jp112sdl/HB-OU-AF-SEN-TEMP/README.md

# HB-OU-AF-SEN-TEMP

Homematic AirFlap Control with Temperature Sensor - Kamin-Luftklappensteuerung mit Temperatursensor (MAX6675) im Rauchrohr<br/>
_benötigt [JP-HB-Devices Addon Version 4.2 oder höher](https://github.com/jp112sdl/JP-HB-Devices-addon/releases)_
<br/>
😤 Ich war es leid, zum Regulieren der Luftzufuhr des Kamins jedes Mal aufstehen zu müssen.<br/>
💡 Eine Automatisierung musste her!<br/><br/>
Wie gut, dass ich erst kürzlich einen defekten 3D Drucker zerlegt hatte, der als idealer Teilespender diente.<br/>
So hatte ich einen NEMA17 Stepper Motor, Linearführung, Umlenkrolle etc. sofort zur Verfügung.<br/>
Der zerlegte Extruder passte auch mit leichten Anpassungen wunderbar unter den "Luftklappen-Nupsi" 😂 der Kamintür.<br/>
<br/>
Die nun noch benötigten Teile habe ich komplett auf Tinkercad konstruiert <br/>
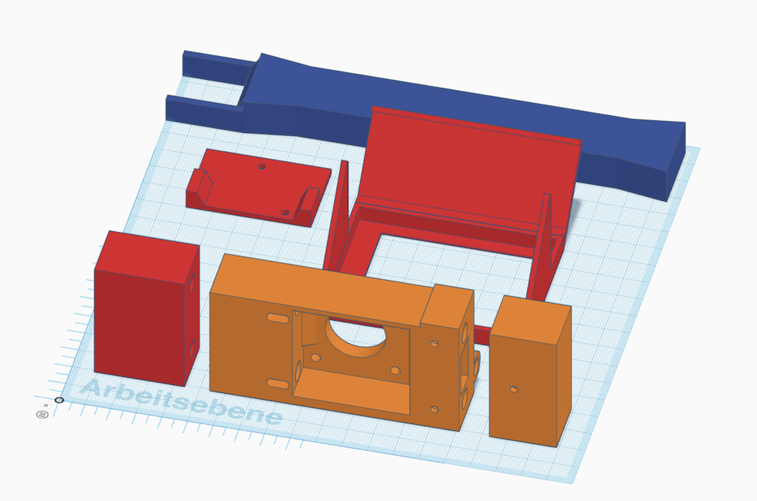
[picture p1: Images/tinkercad.png]
<br/>
und anschließend - wegen der besseren Temperaturbeständigkeit - mit **PETG** gedruckt.

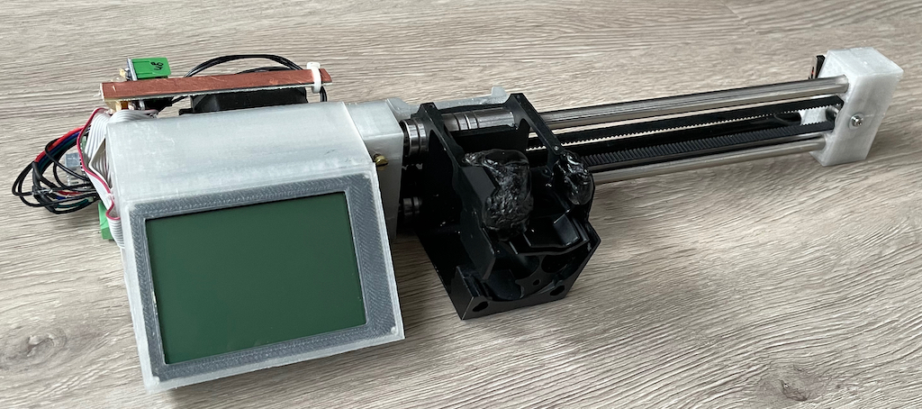
[picture p2: Images/IMG_2078.jpeg]
B1

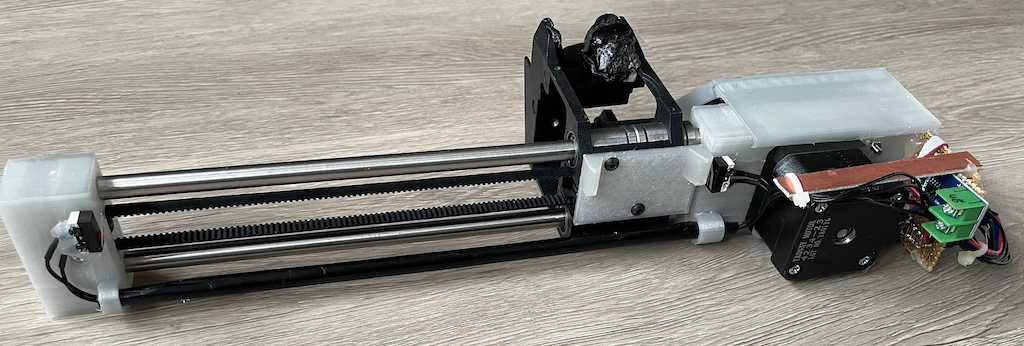
[picture p3: Images/IMG_2079.jpeg]
B2


Die Elektronik:<br/>
Aus meinem [Funkgeräte-Bedienteil-Recycling](https://homematic-forum.de/forum/viewtopic.php?f=76&t=61693&p=610949#p610949) war noch jede Menge übrig, so dass ich mich in erster Linie daran bediente.<br/>
Im Detail habe ich verwendet:<br/>
- ATmega128 AVR mit 14MHz ext. Quarz
- TM12864 LCD Display
- A4988 Stepper Motor Driver
- MAX6675 K-Typ Temperatursensor
- 2 Microschalter als End-Stopps
- CC1101 Funkmodul 868MHz

Verbaut am Kamin:
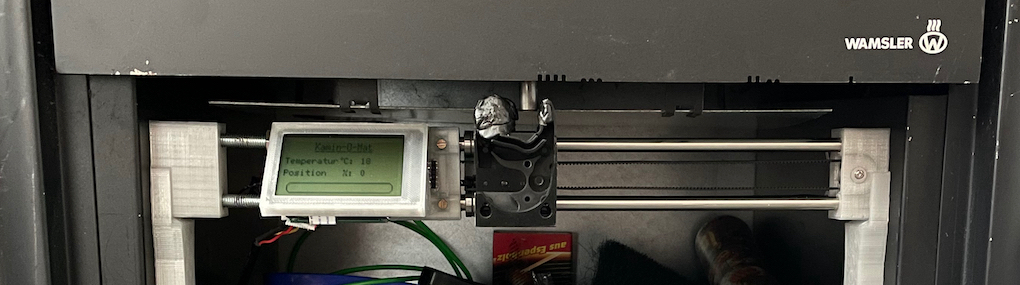
[picture p4: Images/IMG_2085.jpeg]
B3


<br/><br/>
Bei der ersten Inbetriebnahme erfolgt eine automatische Kalibierung.<br/>
Es wird die Anzahl der Schritte zwischen beiden End-Stopps ermittelt und abgespeichert.<br/>
Somit kann dann präzise eine Position (in % der Strecke) angefahren werden.<br/>
<br/><br/>
Steuerung über Homematic:
vid
Higher Quality Video: [click here](https://github.com/jp112sdl/HB-OU-AF-SEN-TEMP/raw/master/Images/IMG_2086.mov)
<br/>
<br/>
Nach dem Anfahren der Position wird der Stepper Motor freigegeben, so dass jederzeit ein manuelles Verschieben möglich ist.<br/>
Leider habe ich keine Möglichkeit gefunden, zuverlässig die absolute Position des Schlittens zu bestimmen.<br/>
Es ist daher notwendig, bei jeder Remote-Ansteuerung zunächst den linken End-Stopp (Nullpunkt) und dann erst die Zielposition anzufahren.
<br/>
<br/>
Zusätzlich ist noch ein MAX6675 Temperatursensor verbaut, der die Temperatur im Abgasrohr misst.
Mithilfe eines kleines Skriptes lasse ich mich über Pushover benachrichtigen, wenn es Zeit wird, Holz nachzulegen.
