jp112sdl/HB-OU-AF-SEN-TEMP/Images/IMG_2080.jpeg

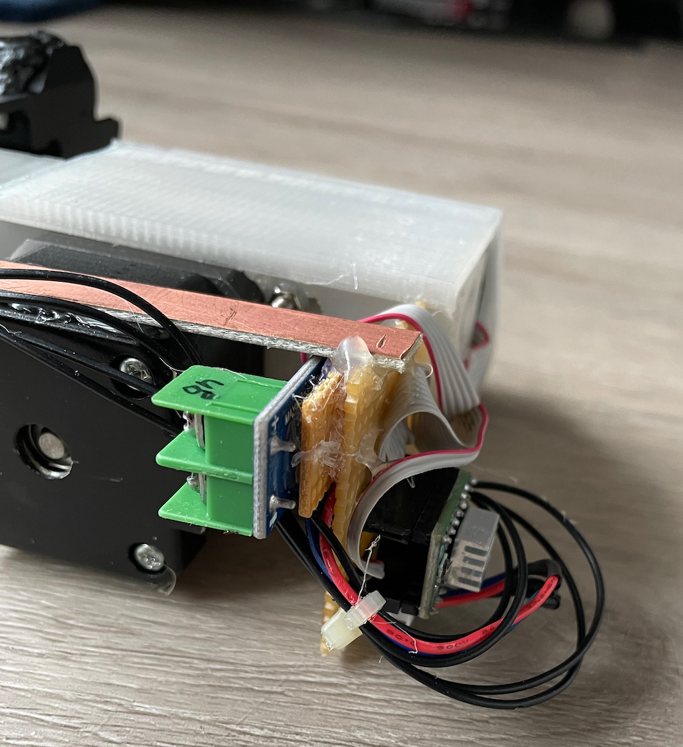
Images/IMG_2080.jpeg
