jp112sdl/HB-OU-AF-SEN-TEMP/Images/IMG_2081.jpeg

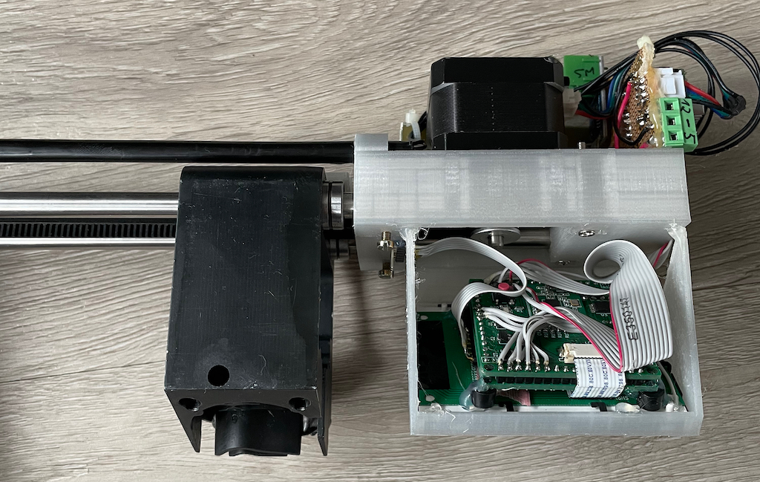
Images/IMG_2081.jpeg
