jp112sdl/HB-OU-AF-SEN-TEMP/Images/IMG_2082.jpeg

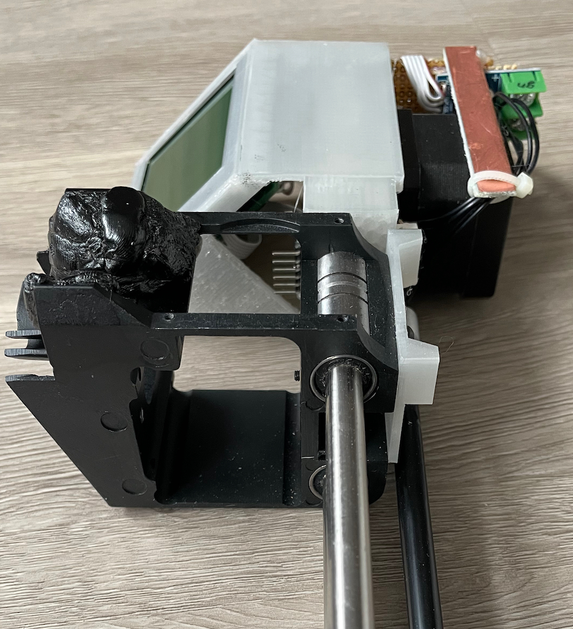
Images/IMG_2082.jpeg
