jp112sdl/HB-OU-AF-SEN-TEMP/Images/IMG_2083.jpeg

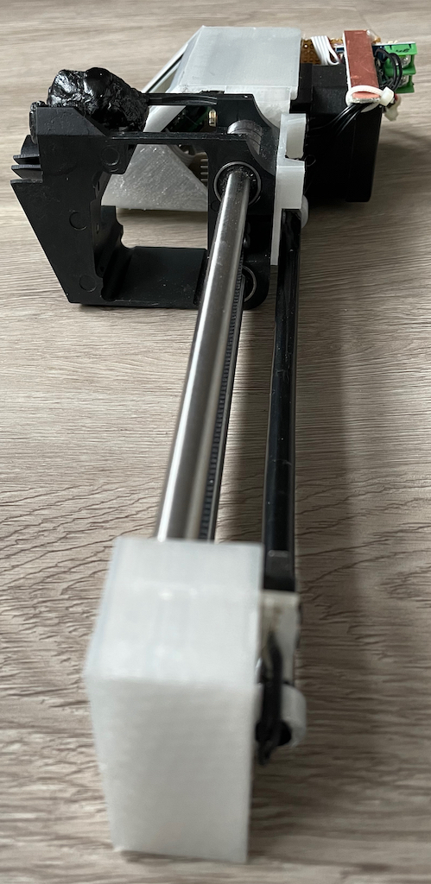
Images/IMG_2083.jpeg
