jp112sdl/HB-OU-AF-SEN-TEMP/Images/IMG_2084.jpeg

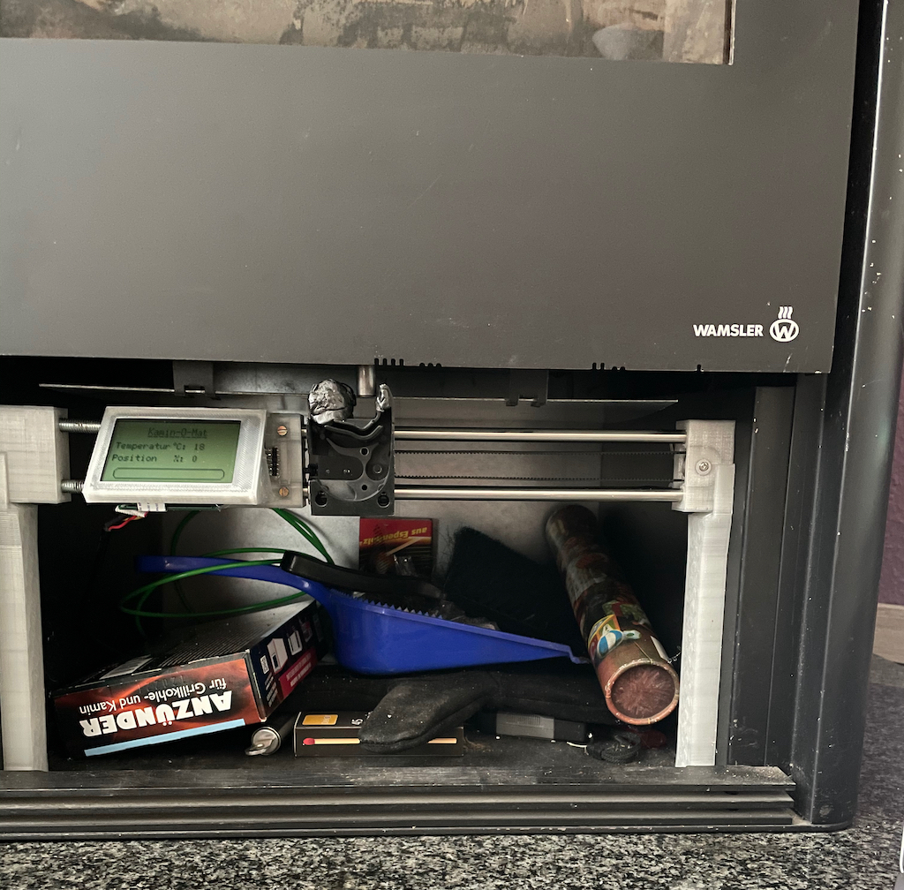
Images/IMG_2084.jpeg
